MoustafaAhmed01/STM32_kICAD/Documents/HardwareCheckList_V43 3 1(PCB Checklist) 1.xlsx

QUANTTRONIX HARDWARE CHECKLIST
PCB checklist
 |  |  |  | Use Case | Status | Notes
General | 1 | V43 | Fill layout's title block (in page setting at bottom right) | ALL | NOT Reviewed
 | 2 |  | Customer's Logo on PCB up on customer request . | Customer Requirement | NOT Reviewed
 | 3 |  | Board Revision on PCB in copper. | ALL | NOT Reviewed
 | 4 |  | PCB layer number on each layer in copper. | ALL | NOT Reviewed
 | 5 |  | Drill legend in f.fab layer for the through hole components and even vias – what sizes are used? | ALL | NOT Reviewed
 | 6 |  | Run ERC , DRC , and solve errors and warnings | ALL | NOT Reviewed
 | 7 |  | Review every and each footprint against its datasheet | ALL | NOT Reviewed
Sizing | 8 |  | Our max target size is 10x10 other than to be clearly justified or requested by customer | Customer Requirement | NOT Reviewed
 | 9 |  | In case of using arcs we have to respect the symmetry and center of the circle | ALL | NOT Reviewed
 | 10 |  | Mounting holes matched 1:1 with mating parts and spacing from board edges are aligned | ALL | NOT Reviewed
 | 11 |  | Review holes diameter for Connectors and pin headers against datasheet | ALL | NOT Reviewed
 | 12 |  | Consider PCB manufacturing panel sizes when deciding on PCB sizes. (Minimize wastage of PCB’s per panel) if requested | MFR Requirement | NOT Reviewed
 | 13 |  | The Components placement Grid to be 0.1mm. Export the centroid files and check for any position above 2 decimals variance | ALL | NOT Reviewed
 | 14 |  | All components & traces >=10 mil from edge of PCB excluding only screw terminals and all connectors | ALL | NOT Reviewed
 | 15 |  | Silk screen legend text width and height >=0.75 mm (30 mil)and to ensure its not covered by any component and readable when the board is populated. | ALL | NOT Reviewed
 | 16 |  | Ensure selecting proper chip sizes for ease soldiering >= 0805 | ALL | NOT Reviewed
 | 17 |  | Check the mask layer of the footprints if any short circuits or interconnection between the pads | ALL | NOT Reviewed
 | 18 |  | We need to ensure the mask layer is reviewed from layout and 3D model prespective according to customer requirment | ALL | NOT Reviewed
Mounting | 19 |  | Ensure Mounting holes are grounded | ALL | NOT Reviewed
 | 20 |  | Allow proper mounting hole clearance for hardware. Allow space around them for stand off mounts, washers, brackets. | ALL | NOT Reviewed
 | 21 |  | All polarized components checked and point same way. Review the +ve signs for all components | ALL | NOT Reviewed
 | 22 |  | Serial number blank on silk screen legend. | ALL | NOT Reviewed
 | 23 |  | Use ground planes where possible. | ALL | NOT Reviewed
 | 24 |  | Ensure mounting holes are fit to the required screws | Customer Requirement | NOT Reviewed
 | 25 |  | Note your board if 1 layer then we can't use thru hole components | ALL | NOT Reviewed
 | 26 |  | Capacitors mounted below or away from heat-dissipating devices such as transformers. | ALL | NOT Reviewed
Components | 27 |  | Ensure there is minimum component body spacing according to the courtyard and the datasheet . | ALL | NOT Reviewed
 | 28 |  | Clearance for IC extraction tools. | ALL | NOT Reviewed
 | 29 |  | Clearance for IC sockets (especially for during proto phase). Sufficient clearance for socketed ICs. | ALL | NOT Reviewed
 | 30 |  | Visual references for automated assembly (ADD FIDUCIALS) Minimum 4 at the corners and to be away from test pads or other circuled footprints and to be min 1mm and Mask 2mm | ALL | NOT Reviewed
 | 31 |  | Ensure pin 1 interpretation and orientation consistent among all connectors of a given type on the board. Ensure the notation is according to the datasheet otherwise to check | ALL | NOT Reviewed
 | 32 |  | All ICs / Connectors have pin one marking visible when chip is installed. | ALL | NOT Reviewed
 | 33 |  | Review all components footprints and dimensions against Datasheet | ALL | NOT Reviewed
 | 34 |  | Check power and ground connections to all ICs. | ALL | NOT Reviewed
 | 35 |  | Ensure all components center are in place in reference to the courtyard and silkscreen | ALL | NOT Reviewed
 | 36 |  | In case we changed footprints for components already used in previous projects, to clearly mention and justify with reference and comparing to old ones | ALL | NOT Reviewed
 | 37 |  | Check the nearby components operating temperature and temperature rating (use higher footprint for higher temperature rating ) | ALL | NOT Reviewed
 | 38 |  | For ultraviolet LEDs circuits , choose Components with temperature rating (AEC-Q200 grade 1 or 0) | UV LEDs PCB | NOT Reviewed
 | 39 |  | For thermal reliefs : increase thermal spoke width for heat exchange to 20mil for the component supposed to high temperature . | High Temperature PCB | NOT Reviewed
 | 40 |  | Write pin labels on any through hole componenets on silkscreen | ALL | NOT Reviewed
 | 41 |  | if tantalum capacitor is used then make sure to have polarity marking in pcb layout | ALL | NOT Reviewed
 | 42 |  | Ensure components names and reference values are not mixed up | ALL | NOT Reviewed
 | 43 |  | For any GND Points or GND Pads that will be soldered in the Production Line, make sure their Pad connection is Thermal Relief connection so that it will be soldered easily | ALL | NOT Reviewed
Tracks and EMI | 44 |  | For inner and outer layers Calculate trace width for each load for ?T 5°C | ALL | NOT Reviewed
 | 45 |  | Ensure having redundancy for power tracks for the main chips | ALL | NOT Reviewed
 | 46 |  | Get trace clearance for each voltage level on KiCad calculator Electrical spacing section | ALL | NOT Reviewed
 | 47 |  | Clearance for high voltage traces and Ensure having copper pour if possible on Top and Bottom for high current paths tracks and increase the Vias for heat dissipation | V > 12V | NOT Reviewed
 | 48 |  | Clearance and guards between noisy and quiet lines. Noisy ones to note are the capacitors on negative rail 7661 chips, RS232 lines, digital lines and busses. In general, any thing with clock & a lot of data tx (SPI/I2C/USB/UART/CAN) while Quiet line: less data comm. Keep noisy lines short. | serial Communication | NOT Reviewed
 | 49 |  | Decoupling capacitors & Crystals are located close to IC power pins (VCC). High frequency crystal cases should be plane to the PCB and grounded so they don’t become an antenna. | ALL | NOT Reviewed
 | 50 |  | Ensure noisy lines far from sensitive components like Crystals, ADC, etc.. And avoid intersection between lines working on high frequency to avoid cross talk | ALL | NOT Reviewed
 | 51 |  | Use guard tracks round high impedance and low noise lines. Keep them short. This is conjunction with having ground planes on all layers | ALL | NOT Reviewed
 | 52 |  | keepout areas observed depending on the layout guide e.x MCU antenna | ALL | NOT Reviewed
 | 53 |  | Digital and analog Voltages is connected through a ferrite bead (same voltage but isolate noise). Ex : VDD & VDDA in MCU | ALL | NOT Reviewed
 | 54 |  | Place I/O devices near where their signals leave the board. | ALL | NOT Reviewed
 | 55 |  | EMI and RFI filtering as close as possible to exit and entry points of shielded areas, I/O connectors. Follow PCB Layout Guidelines for the antenna design. | ALL | NOT Reviewed
 | 56 |  | 13. For high current traces , create a multi-layer zone (2 layers or more) if possible and Provide multiple vias between layers | High Current PCB | NOT Reviewed
 | 57 |  | Minimize ground loops especially at high frequencies . Problem : At high frequencies, ground planes and traces can act as inductors, introducing impedance which makes a voltage differences that can develop across the ground plane due to high-frequency currents, creating "ground loops . Solution : Avoid Narrow Ground Traces , and Place return paths directly beneath signal traces to reduce loop area and minimize inductive coupling . | ALL | NOT Reviewed
 | 58 |  | For the created filled zones , make them symmetric and corners are 90 degree (or 45 degree only if needed) | ALL | NOT Reviewed
 | 59 |  | 16. For high temperature components i.e Ultraviolet LEDs , H-Bridge , LDOs ,… , add a thermistor for thermal feed back if required by the customer . Otherwise recommend to add it | High Temperature PCB | NOT Reviewed
 | 60 |  | For aluminium pcbs :Vias must be greater than or equal : via hole = 0.8mm , via diameter = 1.2mm Check MFR Line parameters | Aluminium PCB | NOT Reviewed
 | 61 |  | For single layer board, all the ground pours are important, so that current can flow evenly so we need to ensure GND planes not disconnected and allow currents flow to avoid overheating . And again Minimize ground loops , Avoid Narrow Ground Traces ,and provide Short Return Paths. | Single layer PCB | NOT Reviewed
 | 62 |  | For ADC Inputs , Make analoge voltage traces shorter to avoid voltage drops and cross talk , place Filtering , decoupling components related to ADC near to the ADC pin | ADC | NOT Reviewed
 | 63 |  | For Multilayer PCBs (4 layers or more) ,for every 2 adjacent layers (F.CU & In1 or B.Cu &In2 ), ensure there is no cross talks or inteference between different power supply lines or signals . If there is must be traces intersection , make sure the intersected traces are 90 degree | Multi-layer PCB >=4 layers | NOT Reviewed
 | 64 |  | Any sensitive/weak signals (Analoge (sensor outputs , OPAMP , ),differential pair , ... ) to be protected and away from any noisy sources even if not in adjacent layers | ALL | NOT Reviewed
 | 65 |  | For 2 layer PCB, it is preferable for High Voltage Tracks (ex: 24V, 1 Amp) to be routed on the layer that will be in the free air (mostly the F.CU) not the housing | ALL | NOT Reviewed
 | 66 |  | Consider grounding any crystals used on the board to proper ground to reduce EMI. | ALL | NOT Reviewed
 | 67 |  | Check setup, hold, and access times for data and address bus according to datasheet to ensure timing compatibility between a microcontroller, memory devices, or other peripherals on a PCB design for synchronization. This is critical to maintaining data integrity and preventing system malfunctions.for layout : Minimize Trace Lengths and Match Trace Lengths for Parallel Buses , use Differential Pair Routing where applicable | ALL | NOT Reviewed
Testability | 68 |  | Provide a ground test point, accessible and sized for scope ground clip. | ALL | NOT Reviewed
 | 69 |  | For board to board connection or board to device (ex. Display) connection especially for FFC, FPC connectors ,Check the connectors orientation and signals order . check also the ribbon cable termination style (top/bottom) to match the connectors | ALL | NOT Reviewed
 | 70 |  | No vias under metal-film resistors and similar poorly insulated parts. | ALL | NOT Reviewed
 | 71 |  | Check for traces which may be susceptible to solder bridging. | Solder jumpers | NOT Reviewed
 | 72 |  | Ensure no components are blockage for any other components reachability and testing and deployment | ALL | NOT Reviewed
Test and Maintenance | 73 |  | Test points on PCBs for critical circuits, hard to reach nets. | ALL | NOT Reviewed
 | 74 |  | Fuses accessible and labeled. Better use resettable Fuses | ALL | NOT Reviewed
