MoustafaAhmed01/STM32_kICAD/Documents/HardwareCheckList_V43_3_1_Full_Reviewed.xlsx

Sheet: Project Requirments
QUANTTRONIX HARDWARE CHECKLIST
Requirments Vs Design
1 | Check the Requirments for the design Vs the implemented Schematic and Layout

Sheet: Schematic Checklist
QUANTTRONIX HARDWARE CHECKLIST
Schematics checklist
 |  |  |  | use case | Status | Notes
Drawing Basics | 1 | v43 | Fill schematic's title block (in page setting at bottom right) | ALL | NOT Reviewed
 | 2 |  | Use a suitable universal file name for schematics, and backup the file. Consider how useful “new_powersupply_Vx_y.scm” will look in a few years. | ALL | NOT Reviewed
 | 3 |  | Ensure Rev number to be unique and incremental differentiating between Major (x) and Minor(y) Changes | ALL | NOT Reviewed
 | 4 |  | Title block completed on all schematic and other drawings. | ALL | NOT Reviewed
 | 5 |  | For every component , Review All Symbols' pins' number and function against the datasheet . Make sure all pins are avaialable in the symbol and not hidden | ALL | NOT Reviewed
 | 6 |  | make sure that the exported netlist is updated with the latest schematic. |  | NOT Reviewed
 | 7 |  | Component Libraries are in a "library" directory in the project | ALL | NOT Reviewed
 | 8 |  | If chip used before, to compare against working reference schematic with the used Microcontroller otherwise check against reference schematic of its devboard and to mention source of the reference circuit | ALL | NOT Reviewed
 | 9 |  | Schematic references link should be added under each circuit | ALL | NOT Reviewed
 | 10 |  | For Designer, in case of new chips, ensure design of circuits is reviewed against the application notes of the chip and the Microcontroller used for special requirements. | ALL | NOT Reviewed
 | 11 |  | Check the data sheet and notes for unfamiliar ICs. Read the small print and also in between the lines. | ALL | NOT Reviewed
 | 12 |  | If any new board version (Either Minor or Major Version), to review against the latest manifactured working board with stating the differences | ALL | NOT Reviewed
 | 13 |  | Any component on the board to have its separate reference circuit/devboard implementation against it | ALL | NOT Reviewed
 | 14 |  | Any component doesn't have a SPICE model and to be replaced by any power source, ensure correct polar direction reference to the origin component ex. photodiode | ALL | NOT Reviewed
 | 15 |  | Ensure thr reference designator of all components starts from index 1 e.x R1 , C1 , U1 , … | ALL | NOT Reviewed
 | 16 |  | In case any new version, to justify and document the changes and its implications compared to the previous version | ALL | NOT Reviewed
 | 17 |  | All circuits references should be documented and shared in a file | ALL | NOT Reviewed
Device Rules | 18 |  | Unused CMOS I/O devices in-circuit or connected through connectors should always be pulled up or down to have its default output state. | ALL | NOT Reviewed
 | 19 |  | For any and each comm protocol lines (I2C, SPI, CAN, etc..) Add pinheaders for logic analyzer to monitor the bus. | Serial communication | NOT Reviewed
 | 20 |  | For any analoge Voltage to be measured or tested , Add a test point . | ALL | NOT Reviewed
 | 21 |  | No outputs joined together except open collector (collector or drain ORed). | ALL | NOT Reviewed
 | 22 |  | CMOS gates always operated by logic levels at the rails to minimize current. Don't mix between digital circuits and analog circuits | ALL | NOT Reviewed
 | 23 |  | For any IC (e.x MCU) Check the input/output current limit and if this I/O pin is connected to a load e.x LED , add a resistor to limit the current . | ALL | NOT Reviewed
 | 24 |  | Open collector outputs have on board pullups unless otherwise according to datasheet and design no need in case external circuit have them Check that output pullup voltage is not restricted unexpectedly by internal clamp diodes | ALL | NOT Reviewed
 | 25 |  | Minimize opamp loads according to opamp datasheet max output current | OP-AMP | NOT Reviewed
 | 26 |  | Ensure inputs of unused opamps are not left floating, and the amplifier is configured appropriately according to the needed output | OP-AMP | NOT Reviewed
 | 27 |  | Ensure OpAmp circuit was simulated using SPICE checked for stability and generate voltage output to input characteristics | OP-AMP | NOT Reviewed
 | 28 |  | Check time delays and slew rates of opamps used as comparators according to the opamp datasheet depending on the application design requirements | OP-AMP | NOT Reviewed
 | 29 |  | Check opamp operating voltage from single or dual supply then check the datasheet for relevant opamp operating limits | OP-AMP | NOT Reviewed
 | 30 |  | No RC filter to be put on output of amplification signal input for ADC measuring such signal after amplification and ensure there is no impedance mismatch | OP-AMP | NOT Reviewed
 | 31 |  | Use current limiting resistors on opamp inputs always | OP-AMP | NOT Reviewed
 | 32 |  | Ensure the drift of the selected OPAMP is accepted according to the design | OP-AMP | NOT Reviewed
 | 33 |  | Check if impedence matching circuit needed in case of cascaded OPAMPs for the input and output inpedence for the cascaded OPAMPs | OP-AMP | NOT Reviewed
 | 34 |  | If the output of OPAMP is expected to be in +ve& -ve range , make sure that the -ve supply voltage is connected to -ve voltage not to GND. | OP-AMP | NOT Reviewed
 | 35 |  | Check output to input voltage range on opamps. It is not always rail to rail (peak to peak supply voltage range). Check against SPICE model simulation | OP-AMP | NOT Reviewed
 | 36 |  | Add RC filter and zener clamp circuit for the external inputs to the ADC . | External Analog INPUT | NOT Reviewed
 | 37 |  | Devices with bidirectional ports (Tx/Rx or Input/Output on same pin) must not have pull down resistors attached – they can toggle the state | ALL | NOT Reviewed
 | 38 |  | For needed Pull up/Down resistors , Even if there is internal Weak resistors Add external hard pull up/down resistors as required e.x 10KOhm | ALL | NOT Reviewed
 | 39 |  | Any resistance with special tolerance or capacitor with special requirement i.e Tantalum or any other component with requiremtns than standard, is clearly stated in the schematic with the values used | ALL | NOT Reviewed
 | 40 |  | Any I2C Bus must have Pullup resistors | ALL | NOT Reviewed
 | 41 |  | Any push button, ensure to have capacitor to avoid debouncing effect | ALL | NOT Reviewed
 | 42 |  | For Voltage regulators, calculate and esnure it can provide power to all of the chips connected to it | ALL | NOT Reviewed
 | 43 | v43 | For each component make sure that the operating voltage is within its rating | ALL | NOT Reviewed
Digital Circuitry | 44 |  | Check capacitance and fan out limits for bus according to datasheet. the fan-out limit for a bus is the maximum number of devices that can be connected to the bus without exceeding the specified load capacitance or output drive strength. | ALL | NOT Reviewed
 | 45 |  | Search for timing races where glitches can be generated. An example is where two signals on different inputs of a gate change at almost the same time (1 – 100 ns). The logic can generate brief glitches | ALL | NOT Reviewed
 | 46 |  | A reset delay circuit (IC or RC) may be required to reset devices to an appropriate state at power up. | ALL | NOT Reviewed
 | 47 |  | Check debugger SWO, SWDIO, SWCLK and reset are correctly connected | ALL | NOT Reviewed
 | 48 |  | Ensure schematic software did / did not separate Vcc from Vdd, Vss from GND as needed. | ALL | NOT Reviewed
Power Supplies | 49 | V43 | Plan the power scheme , select the converter topology ,and calculate efficiency using ADI power planner software | ALL | NOT Reviewed
 | 50 |  | The Regulator/converter circuit and its filtering must be done according the datasheet or its evaluation board | ALL | NOT Reviewed
 | 51 |  | Every power pin of every IC should have a decoupling capacitor. | ALL | NOT Reviewed
 | 52 |  | Use power supply polarity reversal protection on the GND terminal. This also ensures regulator cannot be destroyed by shorted input (battery leads). | ALL | NOT Reviewed
 | 53 |  | In case we have cascaded regulators ensure the first regulator can handle high current states. | ALL | NOT Reviewed
 | 54 |  | Solenoids / Relays and other inductive devices can generate destructive voltages. Ensure of having clamp circuit to protect your circuit | ALL | NOT Reviewed
 | 55 |  | Check operating voltage range of overall system for undervoltage state (low battery condition). | ALL | NOT Reviewed
 | 56 |  | Consider fuses carefully, keeping in mind they protect from fires, and protect the supply, not the load. Please ensure Fuse value match the max current passes by the circuit | ALL | NOT Reviewed
 | 57 |  | Check any chips that at sleep mode will be power down to be isolated from chips that remain powered up using open collector or tristate interface devices with hardware operated control line as appropriate. | ALL | NOT Reviewed
 | 58 |  | Estimate total worst case power supply current, and check that circuit operation agrees. | ALL | NOT Reviewed
 | 59 |  | For buckboosts and solarcells consider the minimum required operating voltage | ALL | NOT Reviewed
Discrete Components | 60 |  | Check polarized coupling capacitors cannot get reverse voltage. Eliminate polarized capacitors where possible. | ALL | NOT Reviewed
 | 61 |  | Check if undervoltage and overvoltage protection is required depending on datasheet | ALL | NOT Reviewed
 | 62 |  | Use tantalum capacitors if Only mentioned in reference schematic or datasheet, | ALL | NOT Reviewed
 | 63 |  | if tantalum capacitor is used then make sure to have polarity marking in schematic | ALL | NOT Reviewed
 | 64 |  | External Oscillators checked for reliable startup and within reset time of clocked systems like microprocessors from datasheet | ALL | NOT Reviewed
 | 65 |  | Check heatsinking requirements for maximum power dissipation and worst-case operating temperatures. | ALL | NOT Reviewed
 | 66 |  | Calculate and mention clearly the power dissipation for the used resistors and ensure covered in BOM | ALL | NOT Reviewed
 | 67 |  | Allow a wide safety margin for resistor power dissipation (< 1/3 rating). They can easily melt solder or char boards. | ALL | NOT Reviewed
 | 68 |  | Ensure the tolerance for selected resistances for Voltage converters to be minimal for accurate values | ALL | NOT Reviewed
 | 69 |  | Keep reverse base-emitter current/voltage on bipolar transistors low (use diode clamps). | ALL | NOT Reviewed
 | 70 |  | Check for voltage transients and high voltages on MOSFET Gates. Clamp gates of MOSFET (Clamping diodes) circuits to keep within ratings. | ALL | NOT Reviewed
 | 71 |  | Add termination resistors (e.g., series or parallel) to match trace impedance and minimize reflections | ALL | NOT Reviewed
 | 72 |  | Separate analog signals from noisy or digital signals. | ALL | NOT Reviewed
 | 73 |  | Ensure ESD protection on USB connectors | USB | NOT Reviewed
 | 74 |  | Selecting any component ensure the electrical specs not at the threshold of the application to avoid spikes impact | ALL | NOT Reviewed
 | 75 |  | For any magnetic coils ensure having free wheeling diode | ALL | NOT Reviewed
Reset and Supervisory & Debugging | 76 |  | For MCU , Review Reset Cictuit against the datasheet recommendation and dev board implemetation | MCU | NOT Reviewed
 | 77 |  | Add an RGB led for debugging | MCU | NOT Reviewed
 | 78 | v43 | Add pin header for logic analyzer to measure the actual task execution time or RTOS debugging | MCU | NOT Reviewed
 | 79 |  | Defaults for switches and settings that make the system work in some defined way. | External Inputs | NOT Reviewed
 | 80 |  | Consider logic pins not connected directly to power or ground but use resistors for in-circuit testing and modifications. | ALL | NOT Reviewed

Sheet: PCB Checklist
QUANTTRONIX HARDWARE CHECKLIST
PCB checklist
 |  |  |  | Use Case | Status | Notes
General | 1 | V43 | Fill layout's title block (in page setting at bottom right) | ALL | PASS | PCB title block contains a title, date, revision, company, and author. Revision text differs from the silk; see check 3.
 | 2 |  | Customer's Logo on PCB up on customer request . | Customer Requirement | NOT VERIFIED | A Quanttronix/Qx mark is on the silk. Confirm it is the approved customer logo and that a logo was requested; replace/add the approved artwork if required.
 | 3 |  | Board Revision on PCB in copper. | ALL | FAIL | Why: title block says “vSETP 2026” while copper silk says “vSEP 2026”. Fix: 1) choose the approved revision string; 2) update both PCB title block and silk text to match exactly; 3) replot Gerbers and verify the revision on the board layers.
 | 4 |  | PCB layer number on each layer in copper. | ALL | FAIL | Why: no layer-number labels were found on F.Cu, In1.Cu, In2.Cu, and B.Cu. Fix: 1) add a distinct layer ID to each copper layer in an area that will remain exposed; 2) use readable text and suitable polarity/orientation; 3) inspect each plotted copper Gerber to confirm the label is on the correct layer.
 | 5 |  | Drill legend in f.fab layer for the through hole components and even vias – what sizes are used? | ALL | FAIL | Why: no drill-size legend was found on F.Fab. Fix: 1) generate the drill table for plated holes, non-plated holes, and vias; 2) place the table on F.Fab with drill diameters and symbols; 3) plot F.Fab and compare every listed size with the drill files.
 | 6 |  | Run ERC , DRC , and solve errors and warnings | ALL | FAIL | Why: ERC found 4 errors and 1 warning; DRC found 9 schematic-parity/footprint issues (missing D1, extra STATUS and four Housing footprints). Clearance checks are set to ignore. Fix: 1) resolve the power-pin errors and USB_B_Micro library mismatch; 2) reconcile D1/STATUS and the four board-only holes between schematic and PCB; 3) restore clearance checking and use the manufacturer rules; 4) rerun ERC/DRC and clear all errors/warnings.
 | 7 |  | Review every and each footprint against its datasheet | ALL | NOT VERIFIED | The BOM has datasheet links for only some parts, so every footprint cannot be checked. Collect the manufacturer datasheet for each fitted part; compare pad dimensions, pitch, pin numbering, exposed pads, and courtyard; document any intentional footprint changes.
Sizing | 8 |  | Our max target size is 10x10 other than to be clearly justified or requested by customer | Customer Requirement | PASS | Measured Edge.Cuts outline is about 49.25 × 47.75 mm, within the 100 × 100 mm target.
 | 9 |  | In case of using arcs we have to respect the symmetry and center of the circle | ALL | PASS | The four rounded outline corners use matching 5.5 mm corner radii and are symmetric.
 | 10 |  | Mounting holes matched 1:1 with mating parts and spacing from board edges are aligned | ALL | NOT VERIFIED | Four M4 mounting-hole footprints are present and their centers are about 5.5 mm from adjacent board edges. The mating-part drawing and washer/standoff envelope were not supplied; overlay that drawing at 1:1 and confirm hole centers and hardware clearance.
 | 11 |  | Review holes diameter for Connectors and pin headers against datasheet | ALL | NOT VERIFIED | Connector/header datasheets and mating parts are not supplied for every connector. For each J reference, compare footprint pitch, hole/pad size, pin numbering, and body clearance to the exact manufacturer part; change the footprint if any dimension differs.
 | 12 |  | Consider PCB manufacturing panel sizes when deciding on PCB sizes. (Minimize wastage of PCB’s per panel) if requested | MFR Requirement | N/A | No customer or fabricator panelization requirement was supplied. Revisit if a panel size or utilization target is specified.
 | 13 |  | The Components placement Grid to be 0.1mm. Export the centroid files and check for any position above 2 decimals variance | ALL | FAIL | Why: the centroid file has 50 component rows off the 0.1 mm grid; 35 rows contain coordinates beyond 2 decimals. Fix: 1) set the placement grid to 0.1 mm; 2) snap/reposition each affected component; 3) re-export centroid positions; 4) confirm every X/Y is on-grid and within the requested decimal precision.
 | 14 |  | All components & traces >=10 mil from edge of PCB excluding only screw terminals and all connectors | ALL | NOT VERIFIED | The project’s DRC clearance severity is “ignore”, so the report does not establish the 10 mil edge-spacing rule. Set copper/board-edge checks to the required 0.254 mm, exclude only approved connector/terminal bodies, rerun DRC, and inspect any exceptions.
 | 15 |  | Silk screen legend text width and height >=0.75 mm (30 mil)and to ensure its not covered by any component and readable when the board is populated. | ALL | FAIL | Why: board graphic text “STM32F4 Project 1 Board | vSEP 2026” is 0.6 × 0.6 mm, below 0.75 mm. Fix: 1) raise all silk legend text height and width to at least 0.75 mm (including references); 2) replot front/back silk; 3) run silk-overlap/edge checks and inspect the populated-board view for coverage and legibility.
 | 16 |  | Ensure selecting proper chip sizes for ease soldiering >= 0805 | ALL | FAIL | Why: the board uses 0402 and 0603 components, below the checklist’s 0805 minimum. Fix: 1) confirm whether the minimum is mandatory or an approved exception; 2) for mandatory parts, select electrically equivalent 0805-or-larger parts and matching footprints; 3) recheck ratings, values, clearances, routing, and BOM; 4) document any approved smaller-package exception.
 | 17 |  | Check the mask layer of the footprints if any short circuits or interconnection between the pads | ALL | NOT VERIFIED | No visual solder-mask review was supplied. DRC reported no solder-mask bridge violation, but inspect F.Mask and B.Mask Gerbers and the 3D/populated view around every fine-pitch pad; correct any openings that merge unintended pads.
 | 18 |  | We need to ensure the mask layer is reviewed from layout and 3D model prespective according to customer requirment | ALL | NOT VERIFIED | No customer mechanical/mask requirements or reviewed 3D view were supplied. Compare both mask layers and the populated 3D model against the enclosure/customer requirements; record and resolve any interference or exposed-copper issue.
Mounting | 19 |  | Ensure Mounting holes are grounded | ALL | PASS | H1–H4 are plated mounting-hole footprints and their copper pads are assigned to GND.
 | 20 |  | Allow proper mounting hole clearance for hardware. Allow space around them for stand off mounts, washers, brackets. | ALL | NOT VERIFIED | The required screw, washer, bracket, and standoff dimensions are not supplied. Overlay the hardware keepout around all four holes and move parts/tracks or holes until the specified clearance is met.
 | 21 |  | All polarized components checked and point same way. Review the +ve signs for all components | ALL | NOT VERIFIED | Polarized diode/LED orientation and plus markings need the exact part pinout. Compare D2–D4 and the status LEDs with their datasheets and schematic; confirm cathode/anode mapping and visible polarity marks in the assembled view.
 | 22 |  | Serial number blank on silk screen legend. | ALL | PASS | No serial-number placeholder or serial number was found on the board silk; the visible text is project/revision branding.
 | 23 |  | Use ground planes where possible. | ALL | PASS | A GND zone exists on In1.Cu (and a +3.3 V zone on In2.Cu), so a ground plane is used.
 | 24 |  | Ensure mounting holes are fit to the required screws | Customer Requirement | NOT VERIFIED | M4 holes are used, but the customer’s required screw/thread and board-to-hardware specification are absent. Confirm the mating screw size and stack-up before approval.
 | 25 |  | Note your board if 1 layer then we can't use thru hole components | ALL | N/A | This is a four-layer board, not a single-layer board.
 | 26 |  | Capacitors mounted below or away from heat-dissipating devices such as transformers. | ALL | NOT VERIFIED | There is no transformer, but the MP2359 buck converter and L2 can dissipate heat. Check their maximum dissipation/temperature against nearby capacitor ratings and the expected ambient temperature using their datasheets.
Components | 27 |  | Ensure there is minimum component body spacing according to the courtyard and the datasheet . | ALL | NOT VERIFIED | No courtyard/body-spacing review against all component datasheets was supplied. Check courtyard collisions and body-to-body clearance in the populated 3D view; fix overlaps or document approved exceptions.
 | 28 |  | Clearance for IC extraction tools. | ALL | NOT VERIFIED | No extraction-tool clearance requirement or 3D review was supplied. Check the MCU and connector access envelopes using the intended extraction/service tools and move obstructing parts if needed.
 | 29 |  | Clearance for IC sockets (especially for during proto phase). Sufficient clearance for socketed ICs. | ALL | N/A | No socketed IC or IC socket footprint is present in the PCB.
 | 30 |  | Visual references for automated assembly (ADD FIDUCIALS) Minimum 4 at the corners and to be away from test pads or other circuled footprints and to be min 1mm and Mask 2mm | ALL | FAIL | Why: no fiducial footprints were found; the checklist requires at least four. Fix: 1) add four global fiducials near board corners; 2) use at least 1 mm copper with a 2 mm solder-mask opening; 3) keep them clear of test pads/components and follow the assembler’s spacing rules; 4) verify the assembly view and centroid output.
 | 31 |  | Ensure pin 1 interpretation and orientation consistent among all connectors of a given type on the board. Ensure the notation is according to the datasheet otherwise to check | ALL | NOT VERIFIED | Connector datasheets and a reviewed assembly view are missing. For each connector type, confirm pin-1 convention and signal order against the mating cable/device; make the silk marking consistent and test orientation on the 3D view.
 | 32 |  | All ICs / Connectors have pin one marking visible when chip is installed. | ALL | NOT VERIFIED | Pin-1 marks were not verified in a populated-board view. Confirm U1/U2 and every connector have a visible dot/notch/triangle after placement; add or reposition the mark if the component body hides it.
 | 33 |  | Review all components footprints and dimensions against Datasheet | ALL | NOT VERIFIED | Footprint dimensions need comparison to each manufacturer datasheet; several BOM entries have no datasheet link. Obtain the exact part numbers and compare land pattern, pitch, drill, body, and polarity before marking pass.
 | 34 |  | Check power and ground connections to all ICs. | ALL | FAIL | Why: ERC reports four undriven power-input errors, including IC1 pin 5, and one symbol-library warning. Fix: 1) identify the real source for each flagged rail; 2) connect the correct power-output symbol or add PWR_FLAG only where an external source genuinely drives the rail; 3) verify IC1 input/ground pins against its datasheet; 4) update/compare the USB_B_Micro symbol pin mapping; 5) rerun ERC and resolve every message.
 | 35 |  | Ensure all components center are in place in reference to the courtyard and silkscreen | ALL | NOT VERIFIED | The saved file does not establish courtyard-to-silk alignment for every part. Inspect each footprint’s center, courtyard, and reference/value silk in the populated 2D/3D view; reposition text or footprint graphics where misaligned.
 | 36 |  | In case we changed footprints for components already used in previous projects, to clearly mention and justify with reference and comparing to old ones | ALL | NOT VERIFIED | No prior-project footprint comparison or change log was supplied. Compare any reused/modified footprints with the previous approved project and document the source, differences, and justification.
 | 37 |  | Check the nearby components operating temperature and temperature rating (use higher footprint for higher temperature rating ) | ALL | NOT VERIFIED | Operating-temperature ratings and ambient/thermal requirements are not provided for all parts. Check every datasheet rating against nearby heat sources and expected ambient; select higher-rated parts/footprints or add thermal management as required.
 | 38 |  | For ultraviolet LEDs circuits , choose Components with temperature rating (AEC-Q200 grade 1 or 0) | UV LEDs PCB | N/A | No ultraviolet LED circuit is present.
 | 39 |  | For thermal reliefs : increase thermal spoke width for heat exchange to 20mil for the component supposed to high temperature . | High Temperature PCB | N/A | No high-temperature use case is specified. Revisit the 20 mil thermal-spoke requirement if a high-temperature component/use case is confirmed.
 | 40 |  | Write pin labels on any through hole componenets on silkscreen | ALL | FAIL | Why: J1/J3/J4 are through-hole connectors, but pin-function labels for every through-hole pin were not found on silk. Fix: 1) add each pin number and function beside the connector on F.SilkS (or a clear F.Fab legend if space is limited); 2) verify orientation against the mating connector; 3) replot silk and check readability when populated.
 | 41 |  | if tantalum capacitor is used then make sure to have polarity marking in pcb layout | ALL | N/A | No tantalum capacitor is listed in the BOM.
 | 42 |  | Ensure components names and reference values are not mixed up | ALL | FAIL | Why: schematic parity reports missing D1, extra footprint STATUS, and four extra Housing footprints; this prevents a reliable reference/value match. Fix: 1) decide whether STATUS is D1 and use one reference consistently; 2) add the missing LED footprint or remove the unintended schematic part; 3) link or intentionally exclude the four board-only mounting footprints; 4) update PCB from schematic and rerun parity.
 | 43 |  | For any GND Points or GND Pads that will be soldered in the Production Line, make sure their Pad connection is Thermal Relief connection so that it will be soldered easily | ALL | NOT VERIFIED | The board has inner copper zones, but production GND-pad thermal connections and spoke widths were not checked against assembly needs. Inspect each production-soldered GND pad’s zone connection; set thermal relief where needed and use at least 20 mil spokes for any identified high-temperature part.
Tracks and EMI | 44 |  | For inner and outer layers Calculate trace width for each load for △T 5°C | ALL | NOT VERIFIED | Load currents and allowable temperature rise are not specified. For every power net, calculate trace width at 5 °C rise using actual copper thickness (the stackup lists 35 µm copper) and compare with routed widths; widen/add copper or vias where needed.
 | 45 |  | Ensure having redundancy for power tracks for the main chips | ALL | NOT VERIFIED | No power-integrity review establishes redundant paths. Identify the main-chip supply/return paths and required current; add parallel copper or a second-layer path with stitching vias where the design review shows a single-point/narrow path.
 | 46 |  | Get trace clearance for each voltage level on KiCad calculator Electrical spacing section | ALL | FAIL | Why: project DRC sets clearance severity to “ignore”, so voltage-dependent spacing has not been checked. Fix: 1) define nominal and maximum voltage for every rail; 2) choose the applicable KiCad spacing rules/manufacturer limits; 3) enable clearance severity; 4) run DRC and fix every undersized gap.
 | 47 |  | Clearance for high voltage traces and Ensure having copper pour if possible on Top and Bottom for high current paths tracks and increase the Vias for heat dissipation | V > 12V | NOT VERIFIED | The board has a +12 V rail, but its maximum input voltage and high-current requirement are not specified. Confirm worst-case voltage; if it can exceed 12 V, check spacing, copper area, and via count against the supply/current and fabricator rules.
 | 48 |  | Clearance and guards between noisy and quiet lines. Noisy ones to note are the capacitors on negative rail 7661 chips, RS232 lines, digital lines and busses. In general, any thing with clock & a lot of data tx (SPI/I2C/USB/UART/CAN) while Quiet line: less data comm. Keep noisy lines short. | serial Communication | NOT VERIFIED | USB, SWD, I²C, and UART signals are present, but noise/quiet separation and guard routing need visual/routing review. Trace each noisy line, keep it short and away from crystal/analog nets, and add grounded guards only where the circuit requires them.
 | 49 |  | Decoupling capacitors & Crystals are located close to IC power pins (VCC). High frequency crystal cases should be plane to the PCB and grounded so they don’t become an antenna. | ALL | NOT VERIFIED | Decoupler/crystal placement and return paths were not reviewed against the MCU datasheet/layout guide. Confirm each supply pin has a nearby capacitor and short return; check Y1 and its load capacitors against the HSE pin recommendations and verify crystal-case grounding.
 | 50 |  | Ensure noisy lines far from sensitive components like Crystals, ADC, etc.. And avoid intersection between lines working on high frequency to avoid cross talk | ALL | NOT VERIFIED | No signal-integrity/placement review was supplied. Inspect USB/clock/digital routing against crystal and any sensitive analog inputs; shorten noisy runs and reroute crossings/adjacent parallel segments where coupling is possible.
 | 51 |  | Use guard tracks round high impedance and low noise lines. Keep them short. This is conjunction with having ground planes on all layers | ALL | NOT VERIFIED | No high-impedance/low-noise net requirement is documented. Identify such nets from the schematic; add short grounded guards and a continuous return plane where required, then verify the guards do not create loops.
 | 52 |  | keepout areas observed depending on the layout guide e.x MCU antenna | ALL | N/A | No antenna or antenna keepout is indicated on this board.
 | 53 |  | Digital and analog Voltages is connected through a ferrite bead (same voltage but isolate noise). Ex : VDD & VDDA in MCU | ALL | FAIL | Why: the only bead FB1 is on the regulator input path (Net-(F1-Pad2) to IC1_IN); the +3.3VA net is not separated from +3.3V by FB1. Fix: 1) confirm VDDA/analog-supply intent; 2) if isolation is required, place FB1 in series between +3.3V and +3.3VA; 3) keep local analog decoupling at the MCU pins; 4) update schematic/PCB and verify the nets in the exported netlist.
 | 54 |  | Place I/O devices near where their signals leave the board. | ALL | PASS | USB connector J5 and its USB protection device U2 are placed at the board edge near the USB entry; other external connectors are also edge-mounted.
 | 55 |  | EMI and RFI filtering as close as possible to exit and entry points of shielded areas, I/O connectors. Follow PCB Layout Guidelines for the antenna design. | ALL | NOT VERIFIED | USB protection is present, but filter/protection placement and any other I/O filtering need layout review. Trace each I/O path from connector to filter/protection and move the protection element immediately beside the entry/exit if routing bypasses it.
 | 56 |  | 13. For high current traces , create a multi-layer zone (2 layers or more) if possible and Provide multiple vias between layers | High Current PCB | N/A | No high-current load is documented; the BOM includes a 250 mA fuse. Revisit if the actual load current qualifies as high current.
 | 57 |  | Minimize ground loops especially at high frequencies . Problem : At high frequencies, ground planes and traces can act as inductors, introducing impedance which makes a voltage differences that can develop across the ground plane due to high-frequency currents, creating "ground loops . Solution : Avoid Narrow Ground Traces , and Place return paths directly beneath signal traces to reduce loop area and minimize inductive coupling . | ALL | NOT VERIFIED | A GND plane is present on In1.Cu, but return-current loops were not analyzed. Review high-frequency signal return paths on adjacent layers and remove narrow/indirect ground paths or plane splits that force large loops.
 | 58 |  | For the created filled zones , make them symmetric and corners are 90 degree (or 45 degree only if needed) | ALL | NOT VERIFIED | The two inner zones were not visually checked for symmetry and corner style. Inspect zone boundaries on the copper-layer plots; use symmetric outlines and 90°/45° corners where practical, then refill zones and rerun DRC.
 | 59 |  | 16. For high temperature components i.e Ultraviolet LEDs , H-Bridge , LDOs ,… , add a thermistor for thermal feed back if required by the customer . Otherwise recommend to add it | High Temperature PCB | N/A | No high-temperature component/use case is specified, so the thermistor recommendation is not triggered.
 | 60 |  | For aluminium pcbs :Vias must be greater than or equal : via hole = 0.8mm , via diameter = 1.2mm Check MFR Line parameters | Aluminium PCB | N/A | Stackup is FR4; this is not an aluminum PCB.
 | 61 |  | For single layer board, all the ground pours are important, so that current can flow evenly so we need to ensure GND planes not disconnected and allow currents flow to avoid overheating . And again Minimize ground loops , Avoid Narrow Ground Traces ,and provide Short Return Paths. | Single layer PCB | N/A | This is a four-layer board, not a single-layer board.
 | 62 |  | For ADC Inputs , Make analoge voltage traces shorter to avoid voltage drops and cross talk , place Filtering , decoupling components related to ADC near to the ADC pin | ADC | N/A | No external ADC input net is identified in the saved netlist. Revisit if an analog sensor/input is added; then shorten the analog route and place its filter/decoupling at the MCU ADC pin.
 | 63 |  | For Multilayer PCBs (4 layers or more) ,for every 2 adjacent layers (F.CU & In1 or B.Cu &In2 ), ensure there is no cross talks or inteference between different power supply lines or signals . If there is must be traces intersection , make sure the intersected traces are 90 degree | Multi-layer PCB >=4 layers | NOT VERIFIED | This is a four-layer board, but adjacent-layer crossings/power-signal coupling were not reviewed. Inspect F.Cu/In1 and B.Cu/In2 together; avoid overlapping unrelated noisy nets, and use near-orthogonal crossings where unavoidable.
 | 64 |  | Any sensitive/weak signals (Analoge (sensor outputs , OPAMP , ),differential pair , ... ) to be protected and away from any noisy sources even if not in adjacent layers | ALL | NOT VERIFIED | No explicit sensitive-signal inventory or noise review was supplied. Identify analog/differential/weak nets, keep them away from switching and clock sources, and verify their reference plane/guarding in every layer.
 | 65 |  | For 2 layer PCB, it is preferable for High Voltage Tracks (ex: 24V, 1 Amp) to be routed on the layer that will be in the free air (mostly the F.CU) not the housing | ALL | N/A | Four copper layers are configured; the two-layer-only high-voltage routing preference does not apply.
 | 66 |  | Consider grounding any crystals used on the board to proper ground to reduce EMI. | ALL | NOT VERIFIED | Y1 has two pads assigned to GND, but the crystal datasheet/case-pad connection was not supplied. Confirm which pads are case/ground pads and follow the crystal manufacturer’s grounding recommendation.
 | 67 |  | Check setup, hold, and access times for data and address bus according to datasheet to ensure timing compatibility between a microcontroller, memory devices, or other peripherals on a PCB design for synchronization. This is critical to maintaining data integrity and preventing system malfunctions.for layout : Minimize Trace Lengths and Match Trace Lengths for Parallel Buses , use Differential Pair Routing where applicable | ALL | NOT VERIFIED | No timing or length-match requirements were supplied. Confirm whether any parallel bus exists; for USB, verify differential-pair class, impedance, skew, and length against the MCU/USB guidance; add length matching only where required.
Testability | 68 |  | Provide a ground test point, accessible and sized for scope ground clip. | ALL | FAIL | Why: no dedicated ground test-point footprint sized for a scope ground clip was found. Fix: 1) add a clearly labeled GND test point with adequate copper/spacing for the clip; 2) place it near the critical test area and keep access unobstructed; 3) verify clip clearance in the populated 3D view.
 | 69 |  | For board to board connection or board to device (ex. Display) connection especially for FFC, FPC connectors ,Check the connectors orientation and signals order . check also the ribbon cable termination style (top/bottom) to match the connectors | ALL | N/A | No FFC/FPC or ribbon-cable connector is present. For each actual connector, still verify pin order and mating orientation against its datasheet.
 | 70 |  | No vias under metal-film resistors and similar poorly insulated parts. | ALL | NOT VERIFIED | The vias-under-resistor check was not completed from a visual layer review. Inspect every metal-film/poorly insulated part against via locations on all copper layers; move any conflicting via or part and rerun DRC.
 | 71 |  | Check for traces which may be susceptible to solder bridging. | Solder jumpers | N/A | No solder-jumper footprint or exposed solder bridge was found in the PCB component list.
 | 72 |  | Ensure no components are blockage for any other components reachability and testing and deployment | ALL | NOT VERIFIED | Physical access and test/service reachability need the enclosure and deployment method. Check that connectors, switch, fuse, mounting hardware, and test points remain reachable when populated and installed; relocate blocking parts.
Test and Maintenance | 73 |  | Test points on PCBs for critical circuits, hard to reach nets. | ALL | FAIL | Why: no dedicated test-point footprints were found for critical/hard-to-reach nets. Fix: 1) identify required production/debug nets; 2) add labeled test-point footprints for those nets and GND; 3) provide probe clearance and pad size; 4) verify access in the populated/installed view.
 | 74 |  | Fuses accessible and labeled. Better use resettable Fuses | ALL | NOT VERIFIED | F1 (250 mA) is present, but its silk label, service access, and resettable-fuse requirement were not verified. Check the fuse datasheet and populated/enclosure view; add a clear F1/rating label and reposition it for replacement, or use an approved resettable fuse if required.

Sheet: Production Files Checklist
QUANTTRONIX HARDWARE CHECKLIST
Production Files Checklist
 |  | Status | Notes
1 | Place Origin point for Drilling reference at the top left of the board | NOT Reviewed
2 | Ensure generating the required centroid file, netlist file, Gerber file and BOM and ensure gerber and drill files are in same zipped file | NOT Reviewed
3 | BOM to be generated using integrated BOM (Bulk-edit fields) to edit components part number , values , and quantities and export the csv for production | NOT Reviewed
4 | When generate the centroid and gerber files In the drill file make sure that the unit is mm instead of inches. | NOT Reviewed
5 | Review customer/MFR Gerber files requirements i.e. cu , adhesive , mask , and paste layers filled and keep out zones | NOT Reviewed
6 | Validate the number of inner layers and the position of the power and ground planes | NOT Reviewed
7 | Check for obsolete and out of stock components and if found to replace with available alternative | NOT Reviewed
8 | Carefull review for all items in BOM against the schematic with the required quantities and availability | NOT Reviewed
9 | Ensure no components from prohibted vendors | NOT Reviewed
10 | Ensure ordering the components for 1 board only unless other specified (Don't go for discounts during BOM generation) | NOT Reviewed
11 | Components prices comparison review specially resistances and capacitors < 10cent | NOT Reviewed
12 | Any resistance with special tolerance or capacitor with special requirement i.e Tantalum or any other component with requiremtns than standard, is clearly stated in the schematic | NOT Reviewed
13 | Ensure all resistances and capacitances are odered in meet with the electrical specifications in schematic | NOT Reviewed
14 | Ensure all resistances, capacitances and inductances sizes are 0805 | NOT Reviewed
15 | DNPs to be reviewed carefully in generated BOM against the schematic | NOT Reviewed
16 | BOM csv re-imported to Website and compared against the items part number on website | NOT Reviewed
17 | In case components missing or already ordered before, to clarify in a separate sheet | NOT Reviewed
18 | Low quantity components (<1000) are red flagged | NOT Reviewed
19 | Generate the BOM list is on checkout card on the purchase website and share the list link | NOT Reviewed
20 | Generate the interactive html page for BOM placement | NOT Reviewed
21 | Ensure the commits are updated with the latest files after uploading them | NOT Reviewed

Sheet: Sheet1
Column1
NOT Reviewed
NOT Applicable
Applied
NOT Applied
