MoustafaAhmed01/STM32_kICAD/Documents/HardwareCheckList_V43 3 1.xlsx

Sheet: Project Requirments
QUANTTRONIX HARDWARE CHECKLIST
Requirments Vs Design
1 | Check the Requirments for the design Vs the implemented Schematic and Layout

Sheet: Schematic Checklist
QUANTTRONIX HARDWARE CHECKLIST
Schematics checklist
 |  |  |  | use case | Status | Notes
Drawing Basics | 1 | v43 | Fill schematic's title block (in page setting at bottom right) | ALL | Applied | el version ykon 1.0 w kda lama tktb l table
 | 2 |  | Use a suitable universal file name for schematics, and backup the file. Consider how useful “new_powersupply_Vx_y.scm” will look in a few years. | ALL | Applied
 | 3 |  | Ensure Rev number to be unique and incremental differentiating between Major (x) and Minor(y) Changes | ALL | Applied | mt3mlsh update 3la nfs el version w ttl3 el update l gded bnfs el version
 | 4 |  | Title block completed on all schematic and other drawings. | ALL | Applied | daymn 2sm l haga k blocks mtkonsh l donya say7a f b3d
 | 5 |  | For every component , Review All Symbols' pins' number and function against the datasheet . Make sure all pins are avaialable in the symbol and not hidden | ALL | Applied | make sure mn l haga l nta ht3mlha download daymn 2nha nfs l mwgoda fl datasheet
 | 6 |  | make sure that the exported netlist is updated with the latest schematic. |  | Applied | b3d mt3ml update PCB fl PCB design part 23ml import ll netlist w 2t2kd 2n kol l components mwgoda 3ndk f3ln
 | 7 |  | Component Libraries are in a "library" directory in the project | ALL | Applied | khod balk el libraries daymn 23mlha linked f nfs el directory y3ny mn l 2khr htkon specific to project msh global
 | 8 |  | If chip used before, to compare against working reference schematic with the used Microcontroller otherwise check against reference schematic of its devboard and to mention source of the reference circuit | ALL | NOT Applicable | lw feh design 2dem l haga ht3mlha fl sherka already kan mwgod khlas tmam lw mfysh w ht3ml mn gded then use datasheet
 | 9 |  | Schematic references link should be added under each circuit | ALL | Applied | mtnsash l datasheet wl ref bta3 kol haga
 | 10 |  | For Designer, in case of new chips, ensure design of circuits is reviewed against the application notes of the chip and the Microcontroller used for special requirements. | ALL | NOT Applicable | datasheet brdo
 | 11 |  | Check the data sheet and notes for unfamiliar ICs. Read the small print and also in between the lines. | ALL | NOT Applicable | datasheet brdo
 | 12 |  | If any new board version (Either Minor or Major Version), to review against the latest manifactured working board with stating the differences | ALL | NOT Applicable | ht3ml compare ll version board l nta 3mlo b 2khr haga lsherka 3mlaha
 | 13 |  | Any component on the board to have its separate reference circuit/devboard implementation against it | ALL | NOT Applicable | mt3mlsh el haga mn dma8k aked l haga de 2t3mlt 2bl kda w shof mfrod tt3ml ezay
 | 14 |  | Any component doesn't have a SPICE model and to be replaced by any power source, ensure correct polar direction reference to the origin component ex. photodiode | ALL | Applied | make sure mn el polarity lw ht8yro b haga tanya
 | 15 |  | Ensure thr reference designator of all components starts from index 1 e.x R1 , C1 , U1 , … | ALL | Applied | khod balk mn trtyb l components mynf3sh ykon feh R1 R2 R4 fen R3? Kda fl tsny3 hy3odo ytoho 3l component w hwa 8alt mn l 3ad 2sln
 | 16 |  | In case any new version, to justify and document the changes and its implications compared to the previous version | ALL | NOT Applicable | 2y haga ht3dlha lazm tkon mwgoda fl document w t2ol 8yrt eh w kda
 | 17 |  | All circuits references should be documented and shared in a file | ALL | NOT Applicable | bt3ml document l kol haga w t2smha ll blocks bt3tk w kda
Device Rules | 18 |  | Unused CMOS I/O devices in-circuit or connected through connectors should always be pulled up or down to have its default output state. | ALL | Applied | fl devices el nta msh htst5dmha lazm tkhly 3ndha default state high or low
 | 19 |  | For any and each comm protocol lines (I2C, SPI, CAN, etc..) Add pinheaders for logic analyzer to monitor the bus. | Serial communication | Applied | 2.54
 | 20 |  | For any analoge Voltage to be measured or tested , Add a test point . | ALL | Applied | l hagat l analog lazm t3ml test points 3shan nt2kd l bytl3 da mzbot
 | 21 |  | No outputs joined together except open collector (collector or drain ORed). | ALL | Applied | 2t2kd 2nk msh 3aml connect l outputs bta3t MCU 3nd points mo3yna m3 b3d 2yla lw kant open drain 3shan 8yr kda mmkn l donya tdrb m3ak w y7sl short f haga mo3yna
 | 22 |  | CMOS gates always operated by logic levels at the rails to minimize current. Don't mix between digital circuits and analog circuits | ALL | NOT Applicable | mynf3sh t3ml connect mben el dig circuits wl analog ydylk unbeh result
 | 23 |  | For any IC (e.x MCU) Check the input/output current limit and if this I/O pin is connected to a load e.x LED , add a resistor to limit the current . | ALL | Applied | hawl daymn t connect el MCU Si m3 el loads y3ny msln V+ > Res > LED > MCU da l sah lakn mtkhlysh l MCU ykon hwa l source 3shan mt3lysh l temp w kda y3ny khaleh 2khro max 3 mA zy l fol
 | 24 |  | Open collector outputs have on board pullups unless otherwise according to datasheet and design no need in case external circuit have them Check that output pullup voltage is not restricted unexpectedly by internal clamp diodes | ALL | Applied | Applied 3la el I2C
 | 25 |  | Minimize opamp loads according to opamp datasheet max output current | OP-AMP | NOT Applicable | mynf3sh ts7b 2ktr ma l op amp m7tago
 | 26 |  | Ensure inputs of unused opamps are not left floating, and the amplifier is configured appropriately according to the needed output | OP-AMP | NOT Applicable | mynf3sh tsyb l inputs fl opamp fl hawa kda3shan mtdmnsh eh l noise l hwlek
 | 27 |  | Ensure OpAmp circuit was simulated using SPICE checked for stability and generate voltage output to input characteristics | OP-AMP | NOT Applicable | 2t2kd mn output wl inputs fl range l expected
 | 28 |  | Check time delays and slew rates of opamps used as comparators according to the opamp datasheet depending on the application design requirements | OP-AMP | NOT Applicable | lw ht3ml comparetor take care mn l time delay w lw cascade make sure feh opamp sab2 l tany wla la
 | 29 |  | Check opamp operating voltage from single or dual supply then check the datasheet for relevant opamp operating limits | OP-AMP | NOT Applicable | check 3l + wl -
 | 30 |  | No RC filter to be put on output of amplification signal input for ADC measuring such signal after amplification and ensure there is no impedance mismatch | OP-AMP | NOT Applicable | mynf3sh t3ml RC filter b3d l output khsosn lw dakhl 3la el ADC 3shan nta mtdmnsh l impedance bta3t l circuit bta3k 3amla ezay w mmkn y7sl mismatch wl donya t3ok khals
 | 31 |  | Use current limiting resistors on opamp inputs always | OP-AMP | NOT Applicable | brdo 3la hasb el datasheet
 | 32 |  | Ensure the drift of the selected OPAMP is accepted according to the design | OP-AMP | NOT Applicable | de based 3la el requirments tt2kd mn l drift bta3 l op amp hal f nfs l range l required wla la
 | 33 |  | Check if impedence matching circuit needed in case of cascaded OPAMPs for the input and output inpedence for the cascaded OPAMPs | OP-AMP | NOT Applicable
 | 34 |  | If the output of OPAMP is expected to be in +ve& -ve range , make sure that the -ve supply voltage is connected to -ve voltage not to GND. | OP-AMP | NOT Applicable
 | 35 |  | Check output to input voltage range on opamps. It is not always rail to rail (peak to peak supply voltage range). Check against SPICE model simulation | OP-AMP | NOT Applicable
 | 36 |  | Add RC filter and zener clamp circuit for the external inputs to the ADC . | External Analog INPUT | NOT Applicable | lw nta 3ayz voltage mo3yn y3ny msln ht3ml voltage divider 2w kda khod balk 2nk t3ml RC Filter w zener diode 3shan t3ml clip 3nd l max voltage l nta 3ayzo w tt2kd 2no msh hy3la 3n kda bs lw kda mn external source w m7tag l RC 3shan t limit l frequency ll haga l nta 3ayzha
 | 37 |  | Devices with bidirectional ports (Tx/Rx or Input/Output on same pin) must not have pull down resistors attached – they can toggle the state | ALL | Applied
 | 38 |  | For needed Pull up/Down resistors , Even if there is internal Weak resistors Add external hard pull up/down resistors as required e.x 10KOhm | ALL | Applied | mt3tmdsh 3la el pull resistance bta3t l MCU 3shan mmkn mtkonsh kafya lek fl 2hsn 2nk t3ml l pull ll circuits l m7taga bara
 | 39 |  | Any resistance with special tolerance or capacitor with special requirement i.e Tantalum or any other component with requiremtns than standard, is clearly stated in the schematic with the values used | ALL | NOT Reviewed | wnta btktb l values wad7 kol haga 1kohm, 0.25W, 0.1% msln
 | 40 |  | Any I2C Bus must have Pullup resistors | ALL | Applied
 | 41 |  | Any push button, ensure to have capacitor to avoid debouncing effect | ALL | Applied
 | 42 |  | For Voltage regulators, calculate and esnure it can provide power to all of the chips connected to it | ALL | Applied | 2t2kd mn l power el ht provido fl voltage regulator 2t2kd 2no hywdr y supply l circuit kolha
 | 43 | v43 | For each component make sure that the operating voltage is within its rating | ALL | Applied
Digital Circuitry | 44 |  | Check capacitance and fan out limits for bus according to datasheet. the fan-out limit for a bus is the maximum number of devices that can be connected to the bus without exceeding the specified load capacitance or output drive strength. | ALL | NOT Applicable
 | 45 |  | Search for timing races where glitches can be generated. An example is where two signals on different inputs of a gate change at almost the same time (1 – 100 ns). The logic can generate brief glitches | ALL | NOT Applicable
 | 46 |  | A reset delay circuit (IC or RC) may be required to reset devices to an appropriate state at power up. | ALL | NOT Applicable | de btkon IC 3shan t3mly delay zy msln lw h3ml reset f el buck converter hyakhod msln 100ms 3shan ykon stable fa b3ml l IC de w btkon feh CAP bn7otaha 3shan bn7sb beha l delay time
 | 47 |  | Check debugger SWO, SWDIO, SWCLK and reset are correctly connected | ALL | Applied
 | 48 |  | Ensure schematic software did / did not separate Vcc from Vdd, Vss from GND as needed. | ALL | Applied
Power Supplies | 49 | V43 | Plan the power scheme , select the converter topology ,and calculate efficiency using ADI power planner software | ALL | NOT Reviewed
 | 50 |  | The Regulator/converter circuit and its filtering must be done according the datasheet or its evaluation board | ALL | Applied | mynf3sh t7ot components b mzagak fl conv/reg el filtering w kol l mwal da mohm f lazm t3mlha zy l datasheet
 | 51 |  | Every power pin of every IC should have a decoupling capacitor. | ALL | Applied
 | 52 |  | Use power supply polarity reversal protection on the GND terminal. This also ensures regulator cannot be destroyed by shorted input (battery leads). | ALL | NOT Applied | 2y external supply lazm t3ml protection 3shan lw wasl l 3aks t2dr t7my l circuit
 | 53 |  | In case we have cascaded regulators ensure the first regulator can handle high current states. | ALL | NOT Applicable
 | 54 |  | Solenoids / Relays and other inductive devices can generate destructive voltages. Ensure of having clamp circuit to protect your circuit | ALL | NOT Applicable | feh 3ndk no3en mn l connection lw 3ndk reverse back volt f ht3ml connect l diode parallel m3 l coil lw by3ml reverse current f ht3ml series diode m3 l coil
 | 55 |  | Check operating voltage range of overall system for undervoltage state (low battery condition). | ALL | NOT Applied
 | 56 |  | Consider fuses carefully, keeping in mind they protect from fires, and protect the supply, not the load. Please ensure Fuse value match the max current passes by the circuit | ALL | Applied
 | 57 |  | Check any chips that at sleep mode will be power down to be isolated from chips that remain powered up using open collector or tristate interface devices with hardware operated control line as appropriate. | ALL | NOT Reviewed
 | 58 |  | Estimate total worst case power supply current, and check that circuit operation agrees. | ALL | NOT Reviewed
 | 59 |  | For buckboosts and solarcells consider the minimum required operating voltage | SolarCells | NOT Applicable
Discrete Components | 60 |  | Check polarized coupling capacitors cannot get reverse voltage. Eliminate polarized capacitors where possible. | ALL | NOT Applicable
 | 61 |  | Check if undervoltage and overvoltage protection is required depending on datasheet | ALL | Applied | hawl t7ot zener diode fl hagat l m7taga protection
 | 62 |  | Use tantalum capacitors if Only mentioned in reference schematic or datasheet, | ALL | Applied
 | 63 |  | if tantalum capacitor is used then make sure to have polarity marking in schematic | ALL | Applied
 | 64 |  | External Oscillators checked for reliable startup and within reset time of clocked systems like microprocessors from datasheet | ALL | NOT Applicable | crystal goz2 mn l oscillator
 | 65 |  | Check heatsinking requirements for maximum power dissipation and worst-case operating temperatures. | ALL | NOT Reviewed
 | 66 |  | Calculate and mention clearly the power dissipation for the used resistors and ensure covered in BOM | ALL | NOT Applied
 | 67 |  | Allow a wide safety margin for resistor power dissipation (< 1/3 rating). They can easily melt solder or char boards. | ALL | NOT Reviewed
 | 68 |  | Ensure the tolerance for selected resistances for Voltage converters to be minimal for accurate values | ALL | NOT Reviewed | 23mlha wla eh
 | 69 |  | Keep reverse base-emitter current/voltage on bipolar transistors low (use diode clamps). | ALL | NOT Applicable
 | 70 |  | Check for voltage transients and high voltages on MOSFET Gates. Clamp gates of MOSFET (Clamping diodes) circuits to keep within ratings. | ALL | Applied
 | 71 |  | Add termination resistors (e.g., series or parallel) to match trace impedance and minimize reflections | ALL | NOT Applicable
 | 72 |  | Separate analog signals from noisy or digital signals. | ALL | Applied
 | 73 |  | Ensure ESD protection on USB connectors | USB | Applied
 | 74 |  | Selecting any component ensure the electrical specs not at the threshold of the application to avoid spikes impact | ALL | Applied
 | 75 |  | For any magnetic coils ensure having free wheeling diode | ALL | NOT Applicable | 7ot parallel w wahed tany in series
Reset and Supervisory & Debugging | 76 |  | For MCU , Review Reset Cictuit against the datasheet recommendation and dev board implemetation | MCU | Applied
 | 77 |  | Add an RGB led for debugging | MCU | Applied
 | 78 | v43 | Add pin header for logic analyzer to measure the actual task execution time or RTOS debugging | MCU | Applied
 | 79 |  | Defaults for switches and settings that make the system work in some defined way. | External Inputs | Applied
 | 80 |  | Consider logic pins not connected directly to power or ground but use resistors for in-circuit testing and modifications. | ALL | NOT Reviewed

Sheet: Sheet2
Components Used
Component No. | Part No. | Link | Others

Sheet: PCB Checklist
QUANTTRONIX HARDWARE CHECKLIST
PCB checklist
 |  |  |  | Use Case | Status | Notes
General | 1 | V43 | Fill layout's title block (in page setting at bottom right) | ALL | Applied
 | 2 |  | Customer's Logo on PCB up on customer request . | Customer Requirement | Applied
 | 3 |  | Board Revision on PCB in copper. | ALL | Applied
 | 4 |  | PCB layer number on each layer in copper. | ALL | Applied
 | 5 |  | Drill legend in f.fab layer for the through hole components and even vias – what sizes are used? | ALL | Applied
 | 6 |  | Run ERC , DRC , and solve errors and warnings | ALL | Applied
 | 7 |  | Review every and each footprint against its datasheet | ALL | Applied
Sizing | 8 |  | Our max target size is 10x10 other than to be clearly justified or requested by customer | Customer Requirement | Applied
 | 9 |  | In case of using arcs we have to respect the symmetry and center of the circle | ALL | Applied
 | 10 |  | Mounting holes matched 1:1 with mating parts and spacing from board edges are aligned | ALL | NOT Reviewed
 | 11 |  | Review holes diameter for Connectors and pin headers against datasheet | ALL | Applied
 | 12 |  | Consider PCB manufacturing panel sizes when deciding on PCB sizes. (Minimize wastage of PCB’s per panel) if requested | MFR Requirement | NOT Applicable
 | 13 |  | The Components placement Grid to be 0.1mm. Export the centroid files and check for any position above 2 decimals variance | ALL | Applied
 | 14 |  | All components & traces >=10 mil from edge of PCB excluding only screw terminals and all connectors | ALL | Applied
 | 15 |  | Silk screen legend text width and height >=0.75 mm (30 mil)and to ensure its not covered by any component and readable when the board is populated. | ALL | NOT Applied | Not all of them
 | 16 |  | Ensure selecting proper chip sizes for ease soldiering >= 0805 | ALL | NOT Applied
 | 17 |  | Check the mask layer of the footprints if any short circuits or interconnection between the pads | ALL | Applied
 | 18 |  | We need to ensure the mask layer is reviewed from layout and 3D model prespective according to customer requirment | ALL | Applied
Mounting | 19 |  | Ensure Mounting holes are grounded | ALL | Applied
 | 20 |  | Allow proper mounting hole clearance for hardware. Allow space around them for stand off mounts, washers, brackets. | ALL | NOT Reviewed
 | 21 |  | All polarized components checked and point same way. Review the +ve signs for all components | ALL | NOT Applicable
 | 22 |  | Serial number blank on silk screen legend. | ALL | NOT Applicable
 | 23 |  | Use ground planes where possible. | ALL | NOT Reviewed
 | 24 |  | Ensure mounting holes are fit to the required screws | Customer Requirement | NOT Reviewed
 | 25 |  | Note your board if 1 layer then we can't use thru hole components | ALL | NOT Applicable
 | 26 |  | Capacitors mounted below or away from heat-dissipating devices such as transformers. | ALL | NOT Reviewed
Components | 27 |  | Ensure there is minimum component body spacing according to the courtyard and the datasheet . | ALL | NOT Reviewed
 | 28 |  | Clearance for IC extraction tools. | ALL | NOT Reviewed
 | 29 |  | Clearance for IC sockets (especially for during proto phase). Sufficient clearance for socketed ICs. | ALL | NOT Reviewed
 | 30 |  | Visual references for automated assembly (ADD FIDUCIALS) Minimum 4 at the corners and to be away from test pads or other circuled footprints and to be min 1mm and Mask 2mm | ALL | NOT Reviewed
 | 31 |  | Ensure pin 1 interpretation and orientation consistent among all connectors of a given type on the board. Ensure the notation is according to the datasheet otherwise to check | ALL | NOT Reviewed
 | 32 |  | All ICs / Connectors have pin one marking visible when chip is installed. | ALL | NOT Reviewed
 | 33 |  | Review all components footprints and dimensions against Datasheet | ALL | Applied
 | 34 |  | Check power and ground connections to all ICs. | ALL | Applied
 | 35 |  | Ensure all components center are in place in reference to the courtyard and silkscreen | ALL | Applied
 | 36 |  | In case we changed footprints for components already used in previous projects, to clearly mention and justify with reference and comparing to old ones | ALL | NOT Applicable
 | 37 |  | Check the nearby components operating temperature and temperature rating (use higher footprint for higher temperature rating ) | ALL | NOT Applied
 | 38 |  | For ultraviolet LEDs circuits , choose Components with temperature rating (AEC-Q200 grade 1 or 0) | UV LEDs PCB | NOT Applicable
 | 39 |  | For thermal reliefs : increase thermal spoke width for heat exchange to 20mil for the component supposed to high temperature . | High Temperature PCB | Applied
 | 40 |  | Write pin labels on any through hole componenets on silkscreen | ALL | Applied
 | 41 |  | if tantalum capacitor is used then make sure to have polarity marking in pcb layout | ALL | NOT Applicable
 | 42 |  | Ensure components names and reference values are not mixed up | ALL | Applied
 | 43 |  | For any GND Points or GND Pads that will be soldered in the Production Line, make sure their Pad connection is Thermal Relief connection so that it will be soldered easily | ALL | NOT Reviewed
Tracks and EMI | 44 |  | For inner and outer layers Calculate trace width for each load for △T 5°C | ALL | Applied
 | 45 |  | Ensure having redundancy for power tracks for the main chips | ALL | NOT Reviewed
 | 46 |  | Get trace clearance for each voltage level on KiCad calculator Electrical spacing section | ALL | Applied
 | 47 |  | Clearance for high voltage traces and Ensure having copper pour if possible on Top and Bottom for high current paths tracks and increase the Vias for heat dissipation | V > 12V | Applied
 | 48 |  | Clearance and guards between noisy and quiet lines. Noisy ones to note are the capacitors on negative rail 7661 chips, RS232 lines, digital lines and busses. In general, any thing with clock & a lot of data tx (SPI/I2C/USB/UART/CAN) while Quiet line: less data comm. Keep noisy lines short. | serial Communication | Applied
 | 49 |  | Decoupling capacitors & Crystals are located close to IC power pins (VCC). High frequency crystal cases should be plane to the PCB and grounded so they don’t become an antenna. | ALL | Applied
 | 50 |  | Ensure noisy lines far from sensitive components like Crystals, ADC, etc.. And avoid intersection between lines working on high frequency to avoid cross talk | ALL | Applied
 | 51 |  | Use guard tracks round high impedance and low noise lines. Keep them short. This is conjunction with having ground planes on all layers | ALL | NOT Applied
 | 52 |  | keepout areas observed depending on the layout guide e.x MCU antenna | ALL | NOT Applicable
 | 53 |  | Digital and analog Voltages is connected through a ferrite bead (same voltage but isolate noise). Ex : VDD & VDDA in MCU | ALL | Applied
 | 54 |  | Place I/O devices near where their signals leave the board. | ALL | Applied
 | 55 |  | EMI and RFI filtering as close as possible to exit and entry points of shielded areas, I/O connectors. Follow PCB Layout Guidelines for the antenna design. | ALL | NOT Reviewed
 | 56 |  | 13. For high current traces , create a multi-layer zone (2 layers or more) if possible and Provide multiple vias between layers | High Current PCB | NOT Applicable
 | 57 |  | Minimize ground loops especially at high frequencies . Problem : At high frequencies, ground planes and traces can act as inductors, introducing impedance which makes a voltage differences that can develop across the ground plane due to high-frequency currents, creating "ground loops . Solution : Avoid Narrow Ground Traces , and Place return paths directly beneath signal traces to reduce loop area and minimize inductive coupling . | ALL | NOT Reviewed
 | 58 |  | For the created filled zones , make them symmetric and corners are 90 degree (or 45 degree only if needed) | ALL | Applied
 | 59 |  | 16. For high temperature components i.e Ultraviolet LEDs , H-Bridge , LDOs ,… , add a thermistor for thermal feed back if required by the customer . Otherwise recommend to add it | High Temperature PCB | NOT Applicable
 | 60 |  | For aluminium pcbs :Vias must be greater than or equal : via hole = 0.8mm , via diameter = 1.2mm Check MFR Line parameters | Aluminium PCB | NOT Applicable
 | 61 |  | For single layer board, all the ground pours are important, so that current can flow evenly so we need to ensure GND planes not disconnected and allow currents flow to avoid overheating . And again Minimize ground loops , Avoid Narrow Ground Traces ,and provide Short Return Paths. | Single layer PCB | NOT Applicable
 | 62 |  | For ADC Inputs , Make analoge voltage traces shorter to avoid voltage drops and cross talk , place Filtering , decoupling components related to ADC near to the ADC pin | ADC | NOT Applicable
 | 63 |  | For Multilayer PCBs (4 layers or more) ,for every 2 adjacent layers (F.CU & In1 or B.Cu &In2 ), ensure there is no cross talks or inteference between different power supply lines or signals . If there is must be traces intersection , make sure the intersected traces are 90 degree | Multi-layer PCB >=4 layers | NOT Reviewed
 | 64 |  | Any sensitive/weak signals (Analoge (sensor outputs , OPAMP , ),differential pair , ... ) to be protected and away from any noisy sources even if not in adjacent layers | ALL | NOT Applicable
 | 65 |  | For 2 layer PCB, it is preferable for High Voltage Tracks (ex: 24V, 1 Amp) to be routed on the layer that will be in the free air (mostly the F.CU) not the housing | ALL | NOT Applicable
 | 66 |  | Consider grounding any crystals used on the board to proper ground to reduce EMI. | ALL | Applied
 | 67 |  | Check setup, hold, and access times for data and address bus according to datasheet to ensure timing compatibility between a microcontroller, memory devices, or other peripherals on a PCB design for synchronization. This is critical to maintaining data integrity and preventing system malfunctions.for layout : Minimize Trace Lengths and Match Trace Lengths for Parallel Buses , use Differential Pair Routing where applicable | ALL | NOT Reviewed
Testability | 68 |  | Provide a ground test point, accessible and sized for scope ground clip. | ALL | Applied
 | 69 |  | For board to board connection or board to device (ex. Display) connection especially for FFC, FPC connectors ,Check the connectors orientation and signals order . check also the ribbon cable termination style (top/bottom) to match the connectors | ALL | NOT Applicable
 | 70 |  | No vias under metal-film resistors and similar poorly insulated parts. | ALL | NOT Applicable
 | 71 |  | Check for traces which may be susceptible to solder bridging. | Solder jumpers | NOT Applicable
 | 72 |  | Ensure no components are blockage for any other components reachability and testing and deployment | ALL | Applied
Test and Maintenance | 73 |  | Test points on PCBs for critical circuits, hard to reach nets. | ALL | Applied
 | 74 |  | Fuses accessible and labeled. Better use resettable Fuses | ALL | Applied

Sheet: Production Files Checklist
QUANTTRONIX HARDWARE CHECKLIST
Production Files Checklist
 |  | Status | Notes
1 | Place Origin point for Drilling reference at the top left of the board | NOT Reviewed
2 | Ensure generating the required centroid file, netlist file, Gerber file and BOM and ensure gerber and drill files are in same zipped file | NOT Reviewed
3 | BOM to be generated using integrated BOM (Bulk-edit fields) to edit components part number , values , and quantities and export the csv for production | NOT Reviewed
4 | When generate the centroid and gerber files In the drill file make sure that the unit is mm instead of inches. | NOT Reviewed
5 | Review customer/MFR Gerber files requirements i.e. cu , adhesive , mask , and paste layers filled and keep out zones | NOT Reviewed
6 | Validate the number of inner layers and the position of the power and ground planes | NOT Reviewed
7 | Check for obsolete and out of stock components and if found to replace with available alternative | NOT Reviewed
8 | Carefull review for all items in BOM against the schematic with the required quantities and availability | NOT Reviewed
9 | Ensure no components from prohibted vendors | NOT Reviewed
10 | Ensure ordering the components for 1 board only unless other specified (Don't go for discounts during BOM generation) | NOT Reviewed
11 | Components prices comparison review specially resistances and capacitors < 10cent | NOT Reviewed
12 | Any resistance with special tolerance or capacitor with special requirement i.e Tantalum or any other component with requiremtns than standard, is clearly stated in the schematic | NOT Reviewed
13 | Ensure all resistances and capacitances are odered in meet with the electrical specifications in schematic | NOT Reviewed
14 | Ensure all resistances, capacitances and inductances sizes are 0805 | NOT Reviewed
15 | DNPs to be reviewed carefully in generated BOM against the schematic | NOT Reviewed
16 | BOM csv re-imported to Website and compared against the items part number on website | NOT Reviewed
17 | In case components missing or already ordered before, to clarify in a separate sheet | NOT Reviewed
18 | Low quantity components (<1000) are red flagged | NOT Reviewed
19 | Generate the BOM list is on checkout card on the purchase website and share the list link | NOT Reviewed
20 | Generate the interactive html page for BOM placement | NOT Reviewed
21 | Ensure the commits are updated with the latest files after uploading them | NOT Reviewed

Sheet: Sheet1
Column1
NOT Reviewed
NOT Applicable
Applied
NOT Applied
