MoustafaAhmed01/STM32_kICAD/STM32F4_REV2/STM32F4_REV2.kicad_pcb

## KiCad design STM32F4_REV2/STM32F4_REV2.kicad_pcb (2026-10-06)

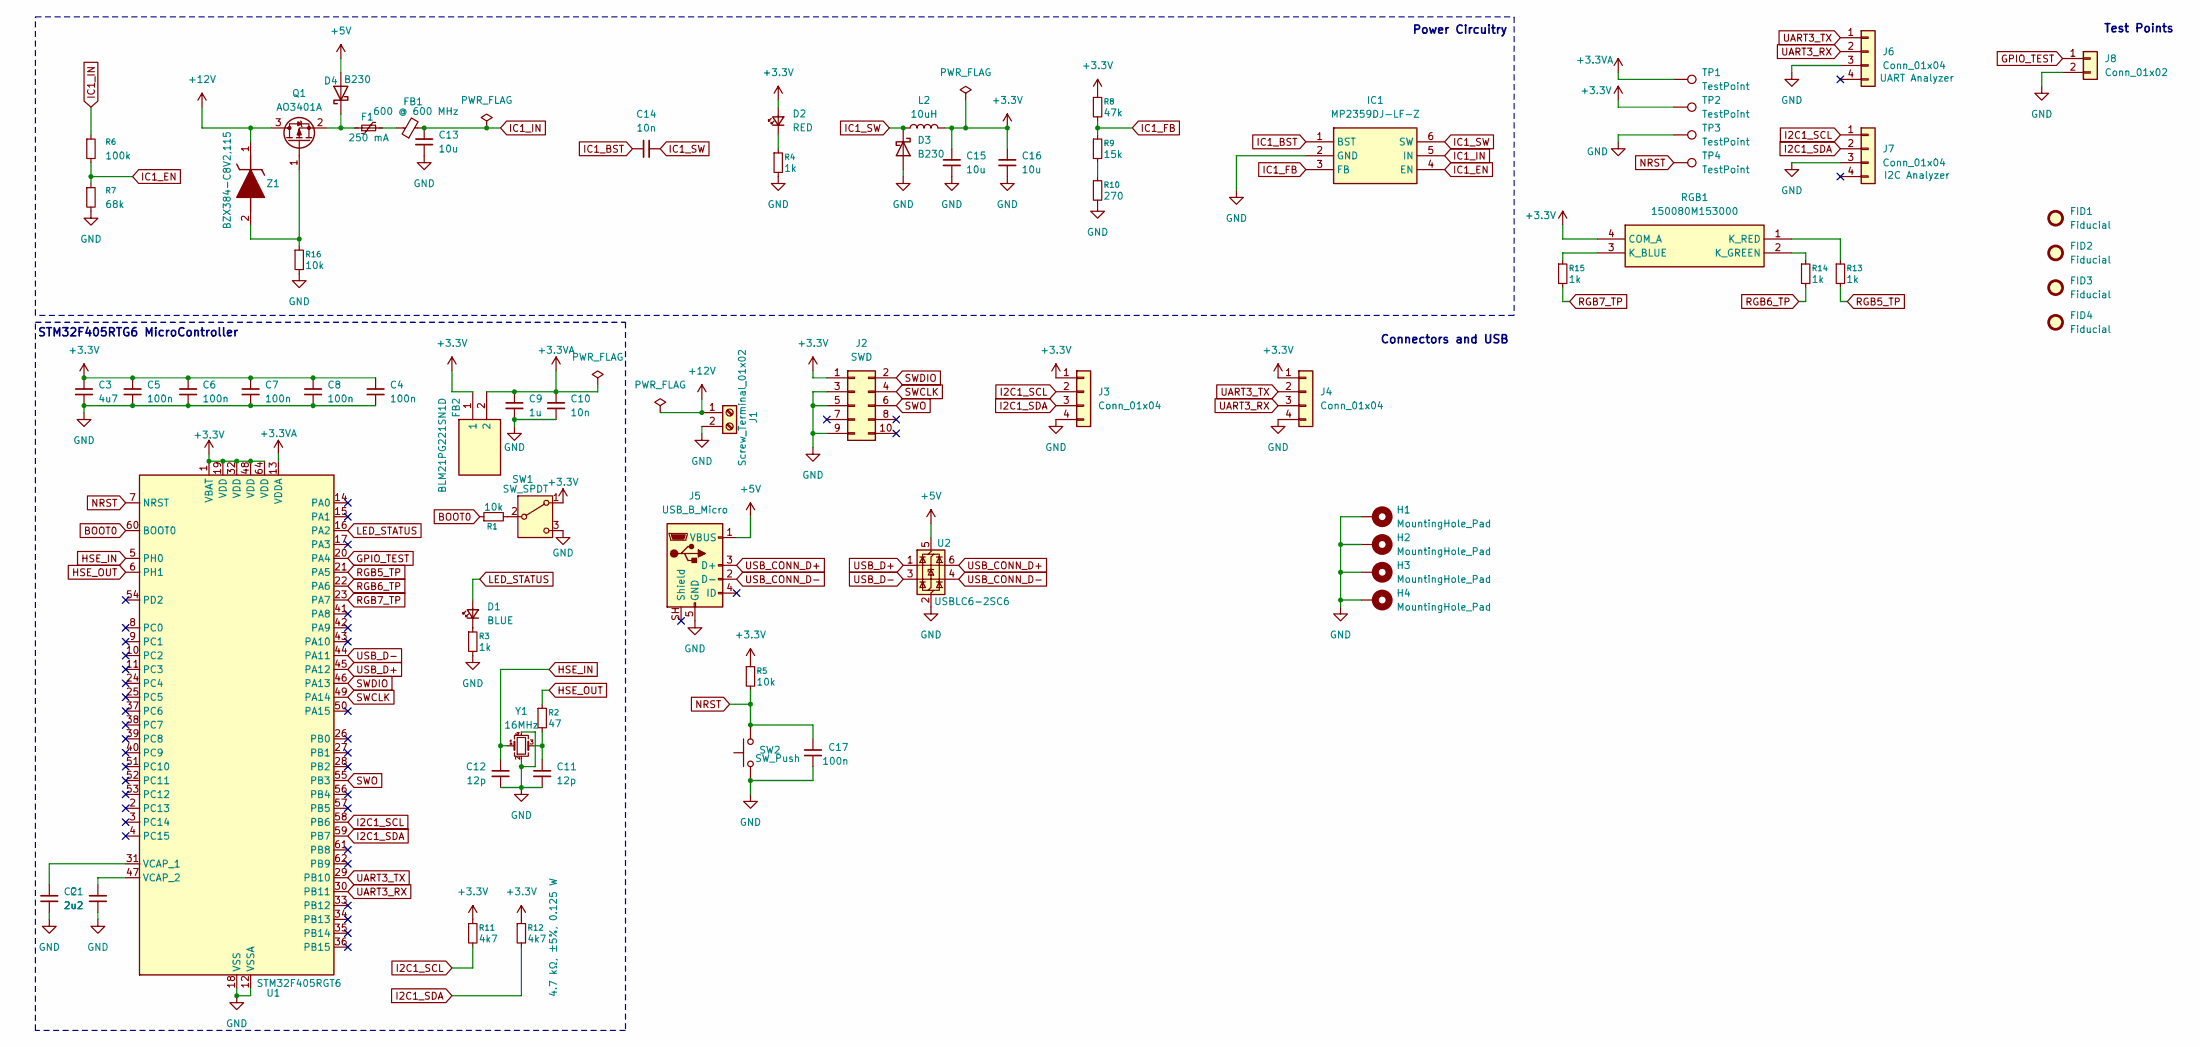
[picture p1: schematic STM32F4_REV2.kicad_sch, STM32F4 Board]

Parts:
C1, C2: 2u2; C_0805_2012Metric
C3: 4u7; C_0805_2012Metric
C4, C5, C6, C7, C8, C17: 100n; C_0805_2012Metric
C9: 1u; C_0805_2012Metric
C10, C14: 10n; C_0805_2012Metric
C11, C12: 12p; C_0805_2012Metric
C13, C15, C16: 10u; C_1206_3216Metric
D1: BLUE; LED_0805_2012Metric
D2: RED; LED_0805_2012Metric
D3, D4: B230; D_SOD-123
F1: 250 mA; Fuse_1206_3216Metric
FB1: 600 @ 600 MHz; C_0805_2012Metric
FB2: BLM21PG221SN1D; BEADC2012X105N; Mouser Part Number 81-BLM21P221SG
FID1, FID2, FID3, FID4: Fiducial; Fiducial_1mm_Mask2mm
H1, H2, H3, H4: MountingHole_Pad; MountingHole_4.3mm_M4_Pad_Via
IC1: MP2359DJ-LF-Z; Mouser Part Number 946-MP2359DJLFZ
J1: Screw_Terminal_01x02; TerminalBlock_Phoenix_PT-1,5-2-3.5-H_1x02_P3.50mm_Horizontal
J2: SWD; PinHeader_2x05_P1.27mm_Vertical_SMD
J3, J4: Conn_01x04; Molex_PicoBlade_53048-0410_1x04_P1.25mm_Horizontal
J5: USB_B_Micro; 101181930001LF
J6, J7: Conn_01x04; PinHeader_1x04_P2.54mm_Vertical
J8: Conn_01x02; PinHeader_1x02_P2.54mm_Vertical
L2: 10uH; L_Sunlord_MWSA0518S
Q1: AO3401A; SOT-23
R1, R5, R16: 10k; R_0805_2012Metric
R2: 47; R_0805_2012Metric
R3, R4, R13, R14, R15: 1k; R_0805_2012Metric
R6: 100k; R_0805_2012Metric
R7: 68k; R_0805_2012Metric
R8: 47k; R_0805_2012Metric
R9: 15k; R_0805_2012Metric
R10: 270; R_0805_2012Metric
R11, R12: 4k7; R_0805_2012Metric
RGB1: 150080M153000; Mouser Part Number 710-150080M153000
SW1: SW_SPDT; SW_SPDT_PCM12
SW2: SW_Push; SW_PUSH_6mm_H5mm
TP1, TP2, TP3, TP4: TestPoint; TestPoint_Pad_D1.5mm
U1: STM32F405RGT6; LQFP-64_10x10mm_P0.5mm
U2: USBLC6-2SC6; SOT-23-6
Y1: 16MHz; Crystal_SMD_3225-4Pin_3.2x2.5mm
Z1: BZX384-C8V2,115; SOD2512X110N; Mouser Part Number 771-BZX384-C8V2115

Connections:
+3.3V: C3.1, C4.1, C5.1, C6.1, C7.1, C8.1, C15.1, C16.1, D2.2 (A), FB2.1, J2.1, J3.1, J4.1, L2.2, R5.1, R8.1, R11.1, R12.1, RGB1.4 (COM_A), SW1.1 (A), TP2.1 (1_1), U1.1 (VBAT), U1.19 (VDD), U1.32 (VDD), U1.48 (VDD), U1.64 (VDD)
+3.3VA: C9.1, C10.1, FB2.2, TP1.1 (1_1), U1.13 (VDDA)
+5V: D4.2 (A), J5.1 (VBUS), U2.5 (VBUS)
+12V: J1.1, Q1.3 (D), Z1.1 (K)
BOOT0: R1.1, U1.60 (BOOT0)
GND: C1.2, C2.2, C3.2, C4.2, C5.2, C6.2, C7.2, C8.2, C9.2, C10.2, C11.2, C12.2, C13.2, C15.2, C16.2, C17.2, D3.2 (A), H1.1 (1_1), H2.1 (1_1), H3.1 (1_1), H4.1 (1_1), IC1.2 (GND), J1.2, J2.3, J2.5, J2.9, J3.4, J4.4, J5.5 (GND), J6.3, J7.3, J8.2, R3.2, R4.2, R7.2, R10.2, R16.2, SW1.3 (C), SW2.1, TP3.1 (1_1), U1.12 (VSSA), U1.18 (VSS), U1.63 (VSS), U2.2 (GND), Y1.2 (G), Y1.4 (G)
GPIO_TEST: J8.1, U1.20 (PA4)
HSE_IN: C12.1, U1.5 (PH0), Y1.1
HSE_OUT: R2.1, U1.6 (PH1)
I2C1_SCL: J3.2, J7.1, R11.2, U1.58 (PB6)
I2C1_SDA: J3.3, J7.2, R12.2, U1.59 (PB7)
IC1_BST: C14.1, IC1.1 (BST)
IC1_EN: IC1.4 (EN), R6.2, R7.1
IC1_FB: IC1.3 (FB), R8.2, R9.1
IC1_IN: C13.1, FB1.2, IC1.5 (IN), R6.1
IC1_SW: C14.2, D3.1 (K), IC1.6 (SW), L2.1
LED_STATUS: D1.2 (A), U1.16 (PA2)
NRST: C17.1, R5.2, SW2.2, TP4.1 (1_1), U1.7 (NRST)
unnamed: C11.1, R2.2, Y1.3
unnamed: D1.1 (K), R3.1
unnamed: D2.1 (K), R4.1
unnamed: D4.1 (K), F1.1, Q1.2 (S)
unnamed: F1.2, FB1.1
unnamed: Q1.1 (G), R16.1, Z1.2 (A)
unnamed: R9.2, R10.1
unnamed: R15.1, RGB1.3 (K_BLUE)
unnamed: R14.1, RGB1.2 (K_GREEN)
unnamed: R13.1, RGB1.1 (K_RED)
unnamed: R1.2, SW1.2 (B)
unnamed: C2.1, U1.31 (VCAP_1)
unnamed: C1.1, U1.47 (VCAP_2)
RGB5_TP: R13.2, U1.21 (PA5)
RGB6_TP: R14.2, U1.22 (PA6)
RGB7_TP: R15.2, U1.23 (PA7)
SWCLK: J2.4, U1.49 (PA14)
SWDIO: J2.2, U1.46 (PA13)
SWO: J2.6, U1.55 (PB3)
UART3_RX: J4.3, J6.2, U1.30 (PB11)
UART3_TX: J4.2, J6.1, U1.29 (PB10)
USB_CONN_D+: J5.3 (D+), U2.6 (I/O1)
USB_CONN_D-: J5.2 (D-), U2.4 (I/O2)
USB_D+: U1.45 (PA12), U2.1 (I/O1)
USB_D-: U1.44 (PA11), U2.3 (I/O2)

Notes on the sheet:
Power Circuitry
Test Points
Connectors and USB
STM32F405RTG6 MicroController

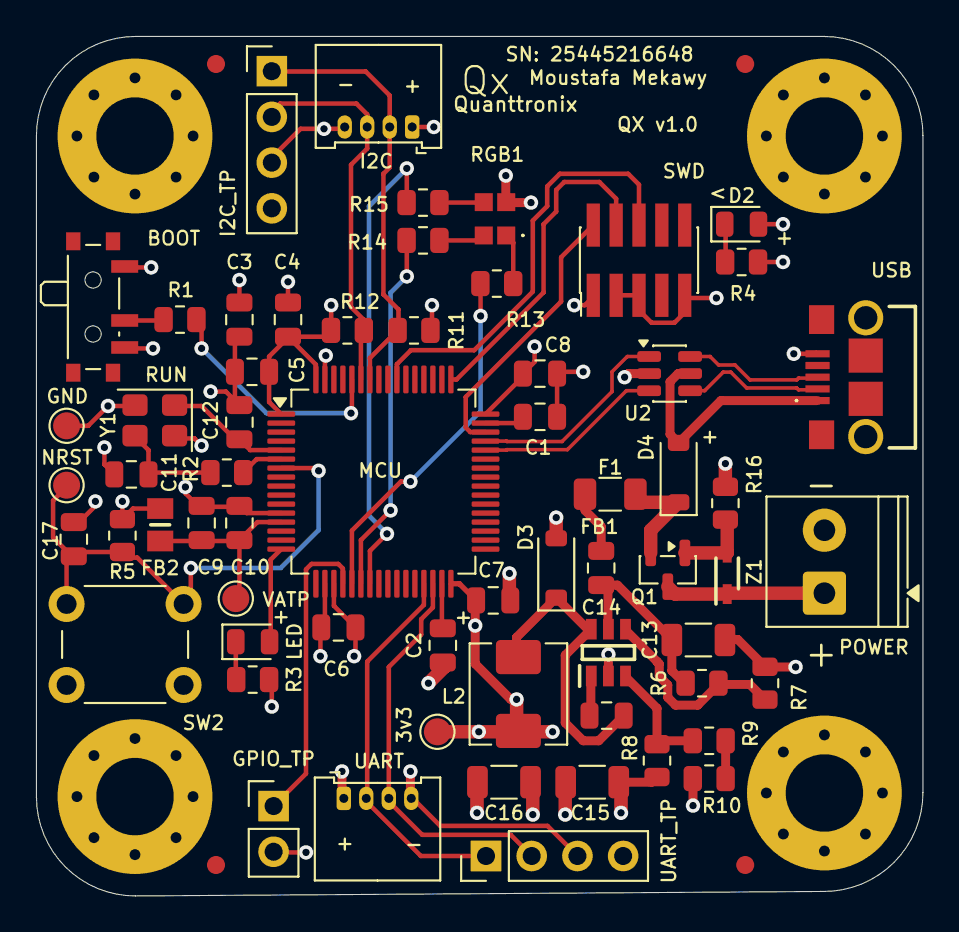
[picture p2: board STM32F4_REV2.kicad_pcb from above]

Board: 4 copper layers, 49.2 x 47.8 mm, 70 parts (0 on the bottom side), 43 nets.
