MoustafaAhmed01/STM32_kICAD/(commit log)

2026-09-28 Uploading the PCB files
    [STM32F4_REV2.kicad_pcb, STM32F4_REV2.kicad_sch]
2026-09-28 Updating the files
    [STM32F4_REV2.kicad_sch]
2026-10-01 Uploading the PCB files kanboard #7406
    [HardwareCheckList_V43 3 1(PCB Checklist) 1.xlsx, HardwareCheckList_V43 3 1.xlsx, HardwareCheckList_V43_3_1_Full_Reviewed.xlsx, HardwareCheckList_V43_3_1_PCB_Reviewed.xlsx]
